3araht/chromatonemini/readme.md

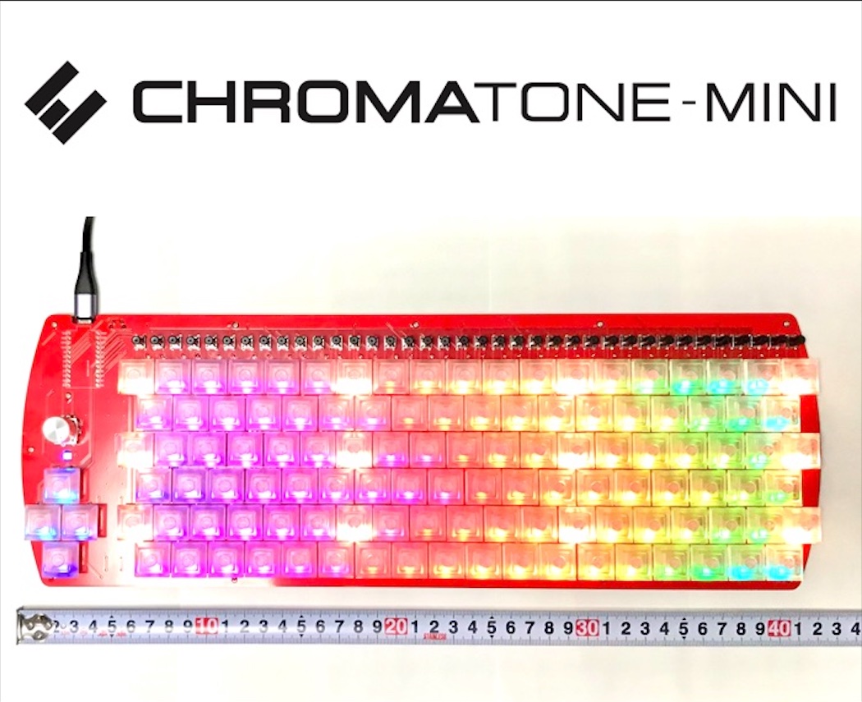
[picture p1: pictures/chromatonemini_toppage.jpg]
chromatonemini


# chromatonemini キーボード
chromatonemini （クロマトーンミニ）キーボードは3オクターブ分（37音）を網羅したシンプルデザインのクロマトーン MIDI キーボードです。
chromatonemini は、クロマトーン発明者の[大川 ワタルさん](https://muto-method.com/profile.html)から受託して作成致しました。
大川さんに自作キーボードキットとしての販売許可をいただきました♪ ロゴも chromatonemini のために提供してくださいました。

カラーリングは [Wholetone Revolution](https://chromatone.jp/chromatone/index.html) をオマージュして赤色になっています（色味は全然ちがいますが。。。）。  

幅は約42cm。ちょうどA3用紙に長手方向の長さくらいです。  
37鍵あるピアノ鍵盤MIDIキーボードより省スペースでDTMに最適？かも知れません。

chromatonemini は PC / Mac / iPad / iPhone / Android などで動作します。

コネクタが Lightning タイプの iPad や iPhone で使う場合、下記に示すアダプターを使って電源供給しながら使えることを確認しています。
iPad や iPhone で chromatonemini を使う場合には電源が必要ですので、必ず "[Lightning - USB 3カメラアダプタ](https://www.apple.com/jp/shop/product/MK0W2AM/A/)" をお使いください。
"Lightning - USBカメラアダプタ" では電源供給ができません。

なお、USB-C タイプの iPad Air 4th Gen で試したところ、電源供給なしに問題なく動作させることができました。

ロータリーエンコーダは長押しでモード切り替えレイヤーへ。短押しでミュート切り替え、回転させるとシステム音量の調整に使用することが可能です。

オプションにより、LED を搭載すれば写真のようにバックライト点灯させることが可能です（LEDのハンダ付けは難易度が高いので、ご注意ください）。

# 外観および使用例
Chromatic Music Lab. の [CHROMATONE-MINI【DEMO】](https://youtu.be/WQA9r8nkZjo) をご覧ください!  
また、こちらに[機能詳細紹介動画](https://youtu.be/7tFm5GolF3g)がございます。

# キーボードキット
chromatonemini キーボードキットは BOOTH でお求めいただけます。  
[BOOTH 販売ページへのリンクはこちら](https://3araht.booth.pm/)。
BOOTH では、chromatonemini の他、クロマチックボタンアコーディオンを模した MIDIキーボードの giabalanai、 giabaLEnai、giabaRInai、giabaRInaix2 がお求めいただけます。

また、遊舎工房さんでも取り扱っていただけるようになりました！！！  
[遊舎工房 chromatonemini 販売ページ](https://shop.yushakobo.jp/collections/keyboard/products/consign_chromatonemini)  

# ファームウェア

chromatonemini は QMK firmware を使っています。Push request が通れば下記からダウンロードできると思います:
[QMK - chromatonemini directory](https://github.com/qmk/qmk_firmware/tree/main/keyboards/chromatonemini)。

暫定的に [こちら](https://github.com/3araht/chromatonemini/blob/main/temp/qmk_firmware/keyboards/chromatonemini) からベータ版をダウンロード下さい。

もしくは、こちらのコンパイル済の [hex file](https://github.com/3araht/chromatonemini/blob/main/chromatonemini_led_hex.zip) をお使いください （RGB_MATRIX 有効）.

# ビルドガイド

[日本語ビルドガイド](https://github.com/3araht/chromatonemini/blob/main/docs/build.md)

分かりやすい組み立てブログは[こちら](https://chromatic.jp/chromatone-mini-create/)です。  

# コンタクト先:
Twitter と YouTube はじめました。  
http://twitter.com/3araht  
https://www.youtube.com/channel/UC0zYtYMoxb0P7S8DPAkl0zA/

# chromatonemini keyboard
chromatonemini keyboard is a simple-design Chromatone mini MIDI keyboard that covers 3 octaves (37 notes).
chromatonemini was created on behalf of [Mr. Wataru Ohkawa](https://muto-method.com/en/profile.html), the inventor of chromatone. Mr. Ohkawa gave me permission to sell it as a keyboard kit ♪ He also provided his logo for chromatonemini.  

chromatonemini works with PC, Mac, iPad, iPhone, and Android.

This work pays homage to [Wholetone Revolution](https://muto-method.com/en/history.html), and the red color is coming from it (The color tone is quite different, though...).  

The width is approx. 42 cm (= 16.5"), as wide as the height of A3 paper size.
Since the 37-key chromatonemini keyboard is smaller than piano type 37-key keyboards, it requires less desk space and might be beneficial for DTM purposes.

When using it with an iPad or iPhone, it works when the below adapter is used with a power supply. The power supply is necessary to use chromatonemini on iPad and iPhone. Make sure to use "[Lightning to USB 3 Camera Adapter](https://www.apple.com/shop/product/MK0W2AM/A/)", not "Lightning to USB Camera Adapter."  

Confirmed with an iPad Air 4th Gen, which has a USB-C port, it worked without the power supply.

A rotary encoder can be used to change the settings of chromatonemini by long-pressing the push-button of the encoder, mute/unmute by clicking, and adjusting the system volume of your computer by rotating the encoder.

# How it looks & how it works
Check this out!  
Chromatic Music Lab. [CHROMATONE-MINI【DEMO】](https://youtu.be/WQA9r8nkZjo)  
A detailed introduction is shown [here](https://youtu.be/7tFm5GolF3g).

# Keyboard kit
The keyboard kit is available from [BOOTH](https://3araht.booth.pm/).  

Click [here](https://www.tenso.com/en/static/lp_shop_booth) for BOOTH overseas shipping!

It is available from Yushakobo as well!!!  
[Yushakobo chromatonemini page](https://shop.yushakobo.jp/collections/keyboard/products/consign_chromatonemini)  

# Firmware

chromatonemini uses QMK for its firmware. The codes for it will be available here as the push request is accepted:
[QMK - chromatonemini directory](https://github.com/qmk/qmk_firmware/tree/main/keyboards/chromatonemini).

Temporarily, please download codes from [here](https://github.com/3araht/chromatonemini/blob/main/temp/qmk_firmware/keyboards/chromatonemini) as a "beta" version.

Or, use this pre-compiled [hex file](https://github.com/3araht/chromatonemini/blob/main/chromatonemini_led_hex.zip) for your convenience (RGB_MATRIX enabled).

# Build Guide

[Japanese Build Guide](https://github.com/3araht/chromatonemini/blob/main/docs/build.md)  
Try [Google Translated guide](https://translate.google.com/translate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) for your language preferences. Trust me, it works quite well, more than expected.

[Here](https://chromatic.jp/chromatone-mini-create/) you can find a better guide.
Try [Google Translated guide](https://translate.google.com/translate?sl=ja&tl=en&u=https://chromatic.jp/chromatone-mini-create/).

# Contact
If you need any help, you know where to find me.  
http://twitter.com/3araht  
https://www.youtube.com/channel/UC0zYtYMoxb0P7S8DPAkl0zA/
