3araht/chromatonemini/pictures/20210429_chromatonemini_FN_layer.png

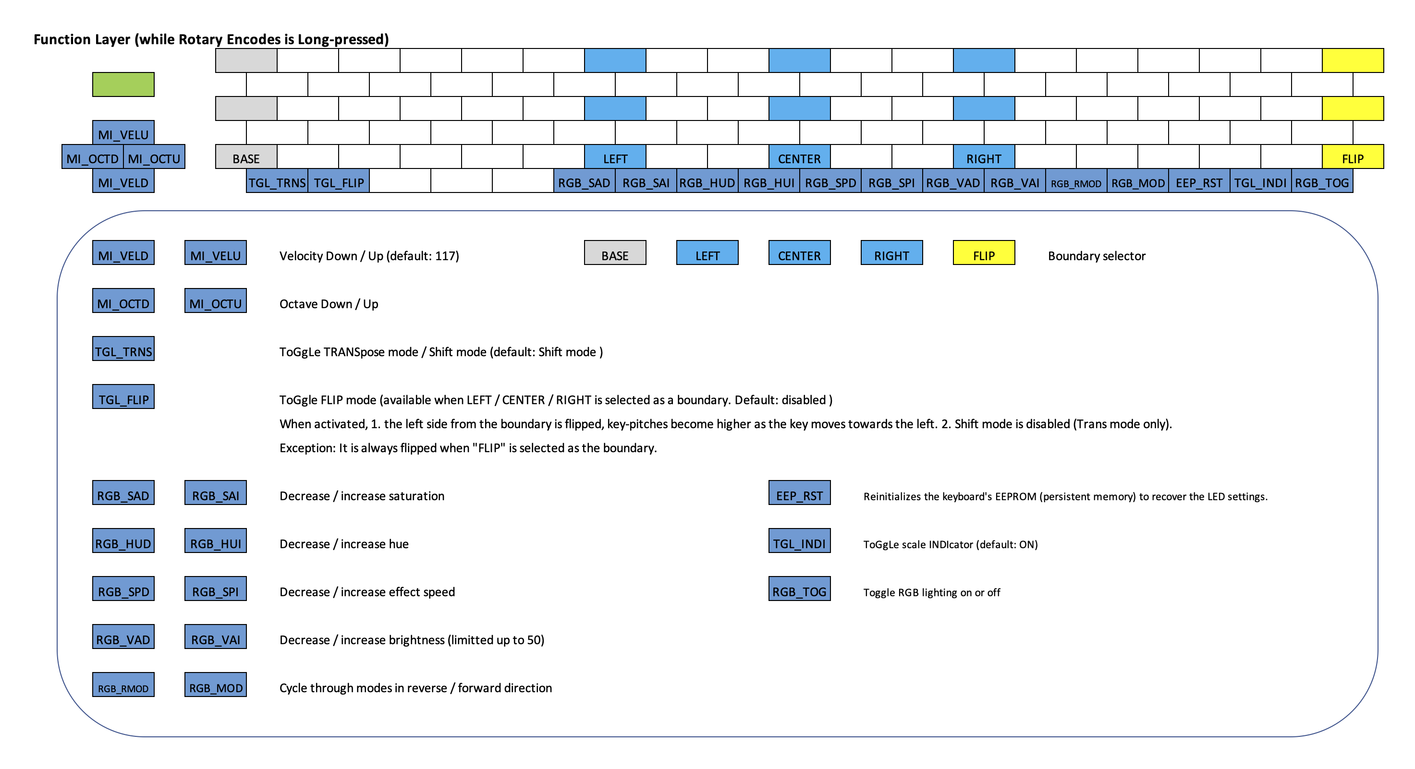
pictures/20210429_chromatonemini_FN_layer.png
