3araht/chromatonemini/pictures/20210429_chromatonemini_notes_layout.png

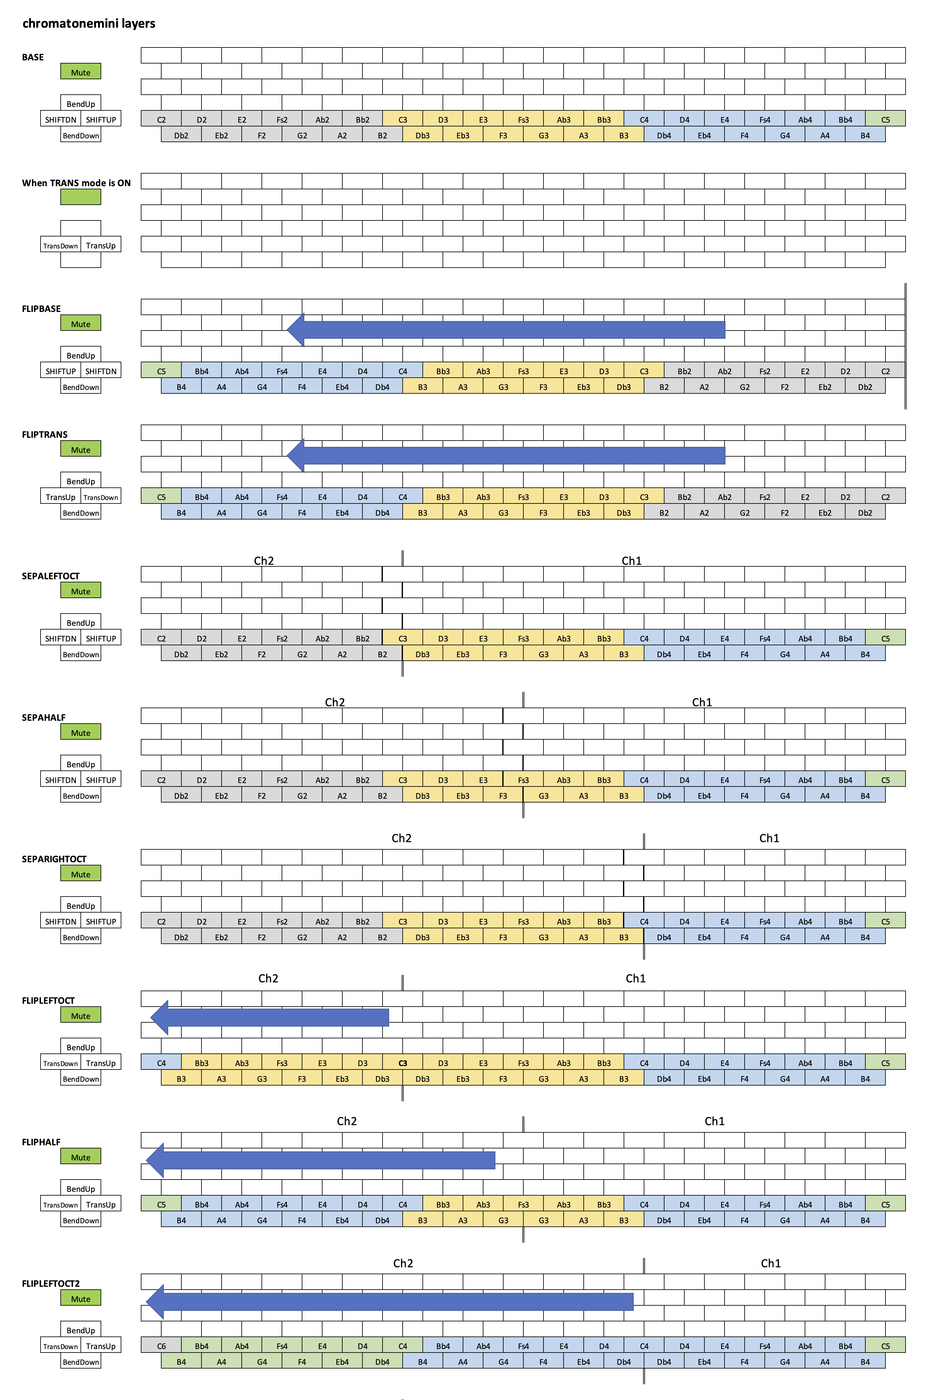
pictures/20210429_chromatonemini_notes_layout.png
