3araht/chromatonemini/pictures/20210501_chromatonemini_FN_layer.png

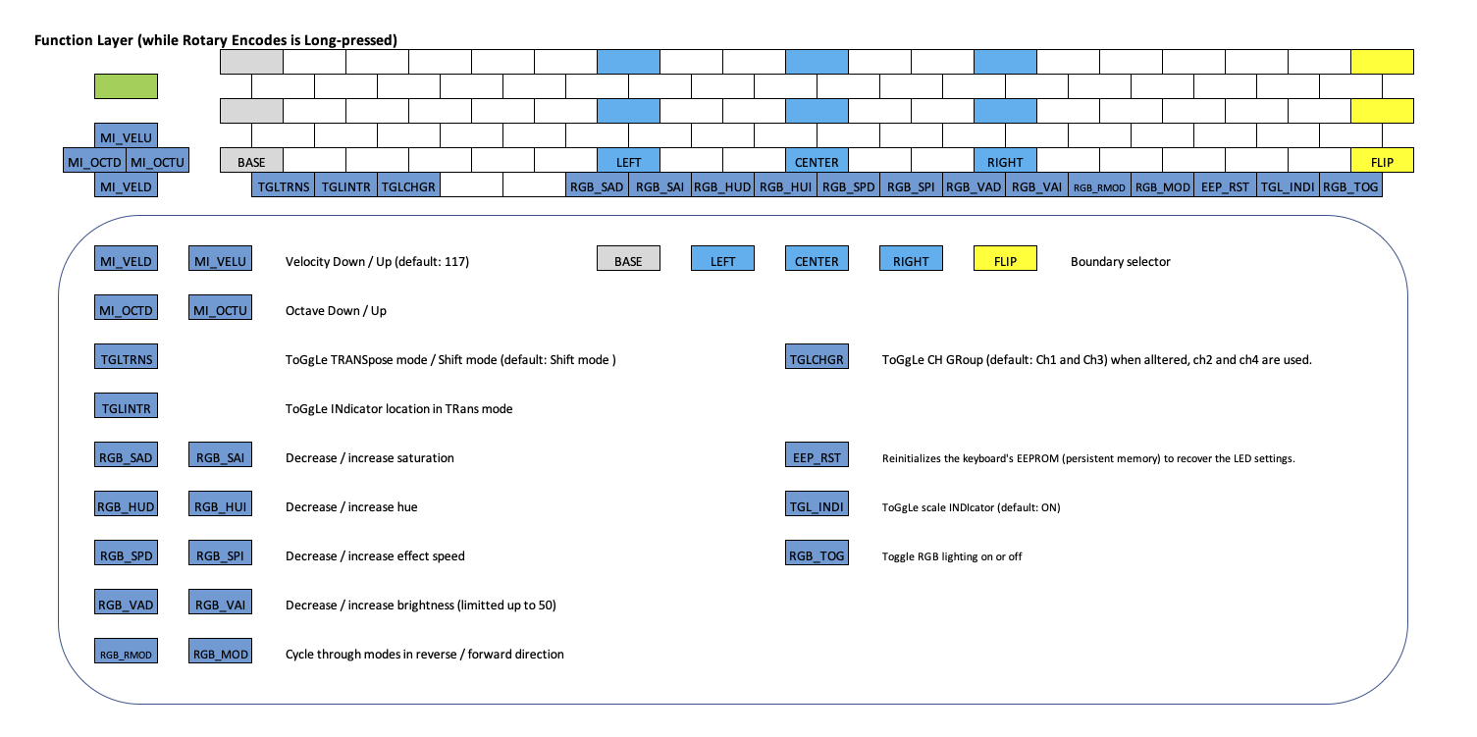
pictures/20210501_chromatonemini_FN_layer.png
