3araht/chromatonemini/pictures/BottomPlate_rear_r01.jpg

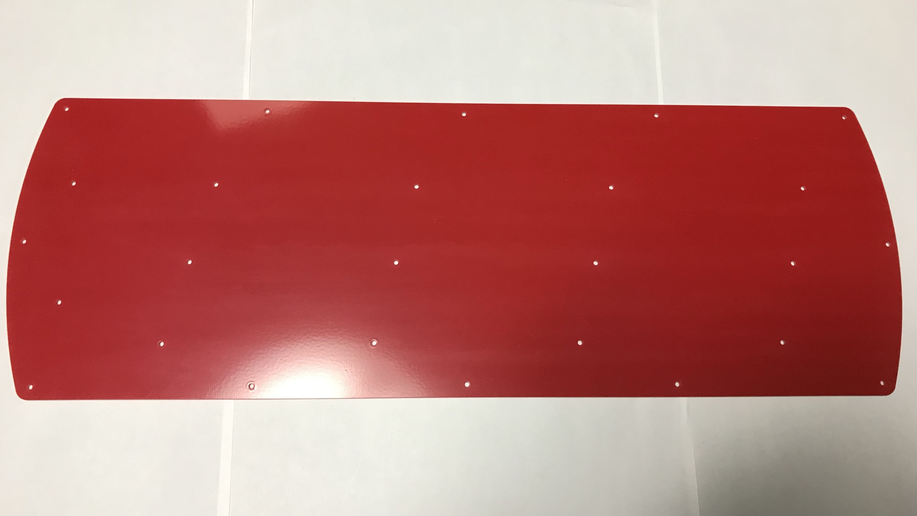
pictures/BottomPlate_rear_r01.jpg
