3araht/chromatonemini/pictures/chromatone-mini.png

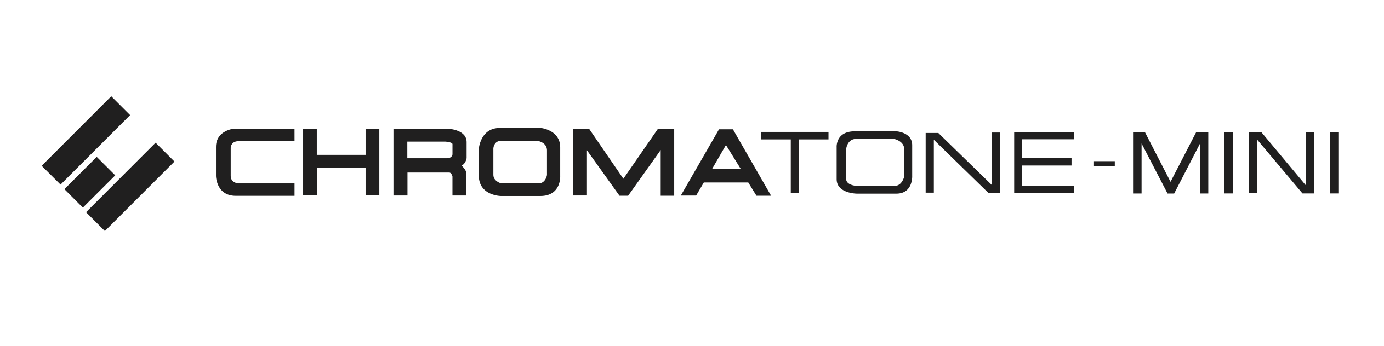
pictures/chromatone-mini.png
