3araht/chromatonemini/pictures/chromatonemini_frontview.jpg

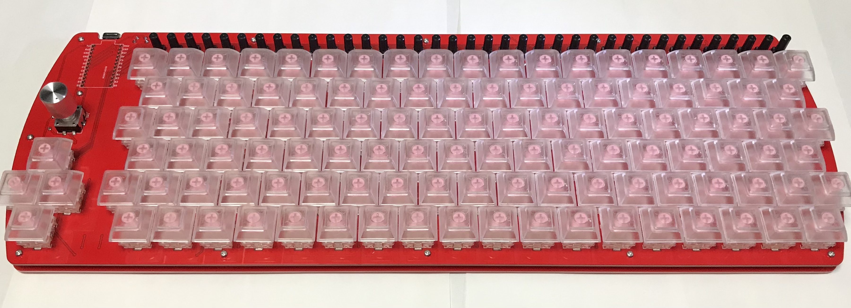
pictures/chromatonemini_frontview.jpg
