3araht/chromatonemini/pictures/chromatonemini_overview.jpg

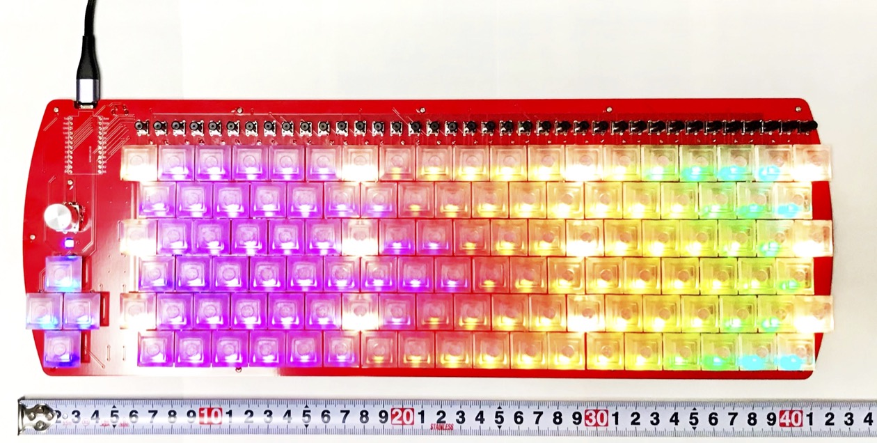
pictures/chromatonemini_overview.jpg
