3araht/chromatonemini/pictures/chromatonemini_tactsw.jpg

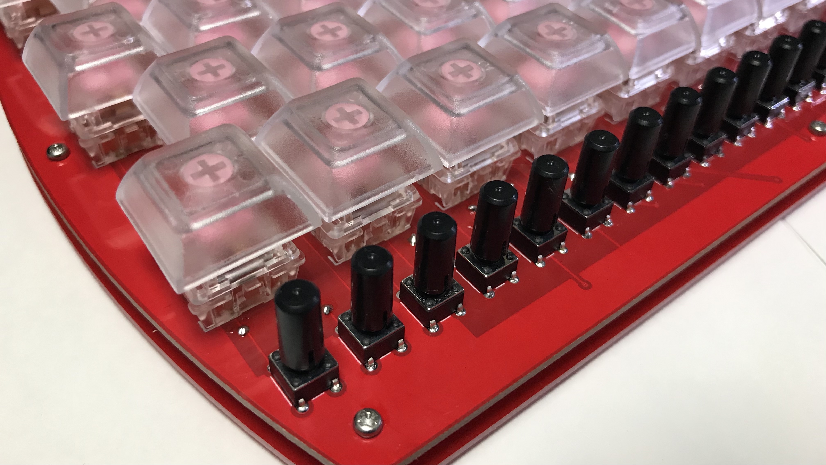
pictures/chromatonemini_tactsw.jpg
