3araht/chromatonemini/pictures/chromatonemini_upperright.jpg

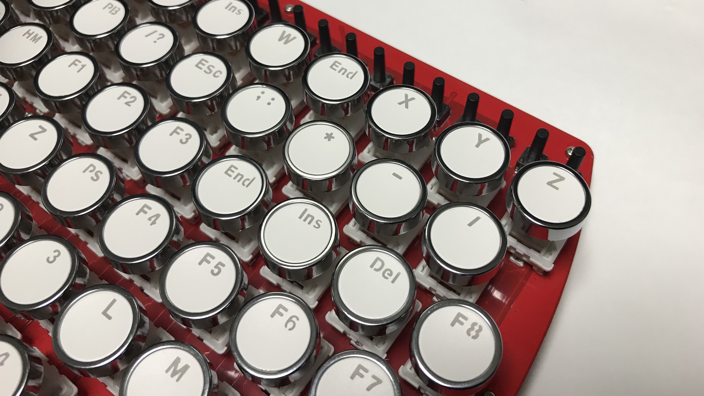
pictures/chromatonemini_upperright.jpg
