3araht/chromatonemini/pictures/FX-600A_220degC.jpg

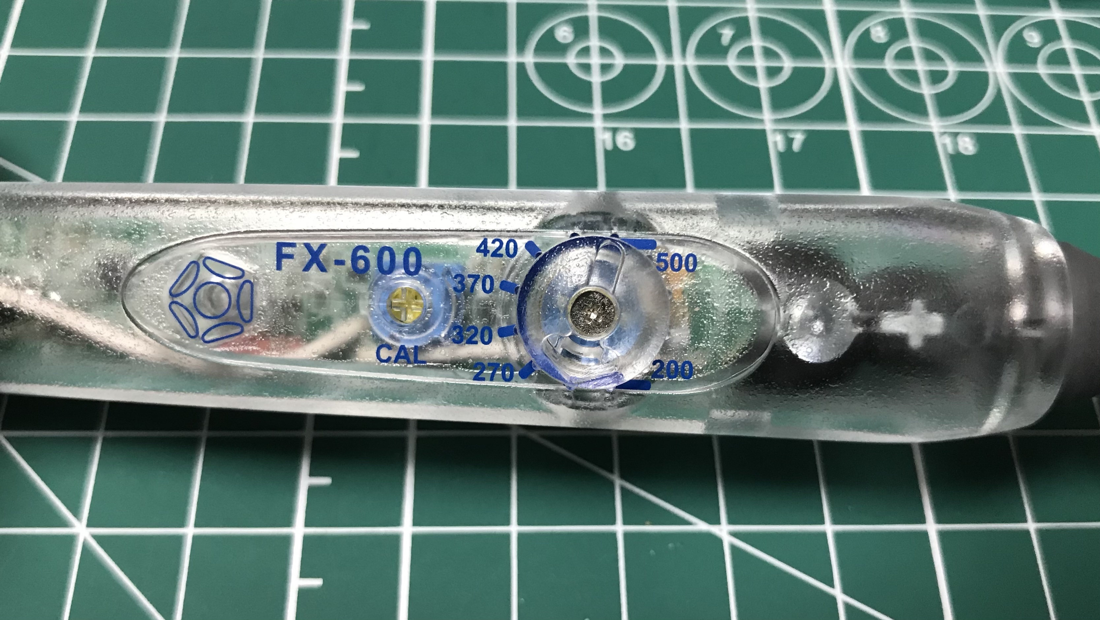
pictures/FX-600A_220degC.jpg
