3araht/chromatonemini/pictures/magnetUSB.jpg

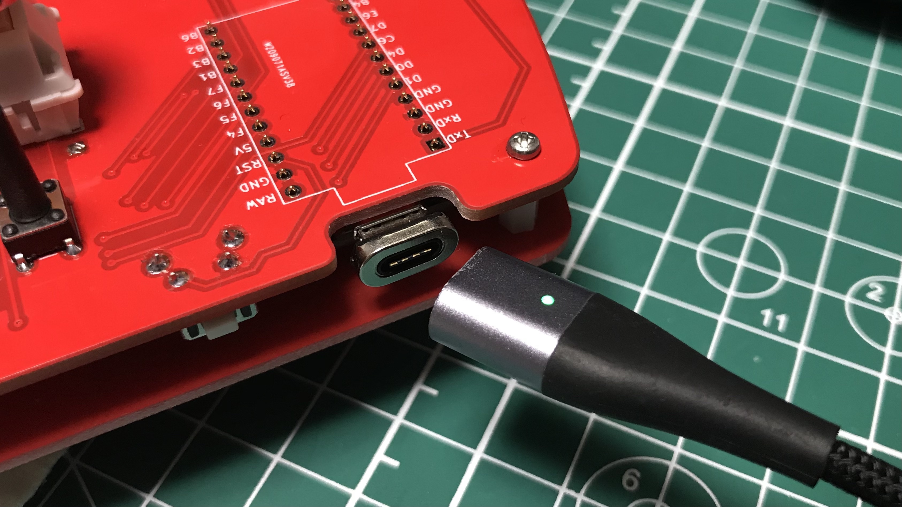
pictures/magnetUSB.jpg
