3araht/chromatonemini/pictures/TactSw_1_r01.jpg

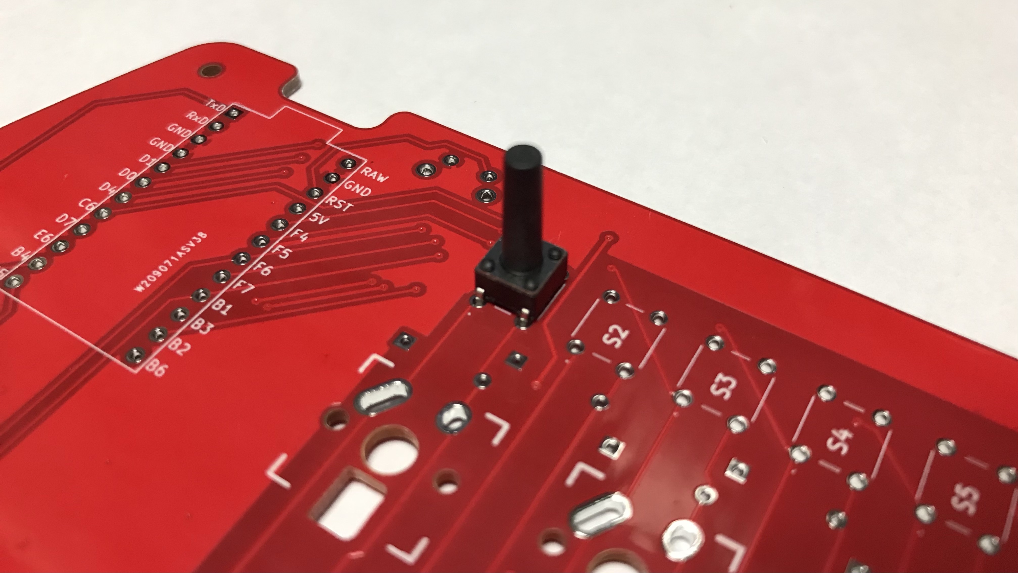
pictures/TactSw_1_r01.jpg
