3araht/chromatonemini/pictures/TactSw_r01.jpg

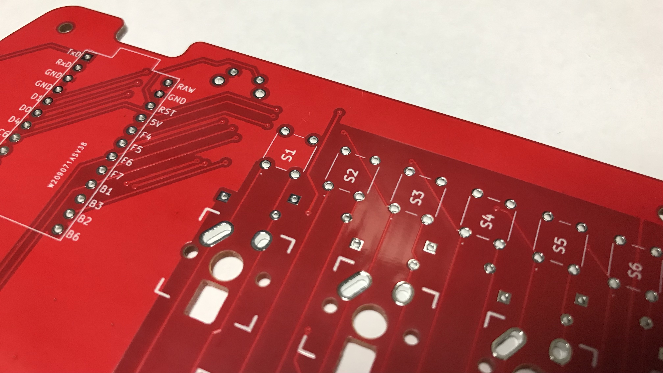
pictures/TactSw_r01.jpg
