3araht/chromatonemini/(commit log)

2021-06-08 encoder_update_user() definition has changed.
2021-07-11 Encoder is customizable from REMAP.
2021-07-15 REMAP support for Encoders fixed.
2021-07-23 Party rocks mode added to led keymap.
2021-11-23 Drashna's method is applied to rotary encoder rotation detection. VIA is now RGB MATRIX enabled. LTO_ENABLED.
